im-deltax/EMG-Human-Machine-Interface/EMG8_Wireless.kicad_pcb

## KiCad design EMG8_Wireless.kicad_pcb (2026-10-22)

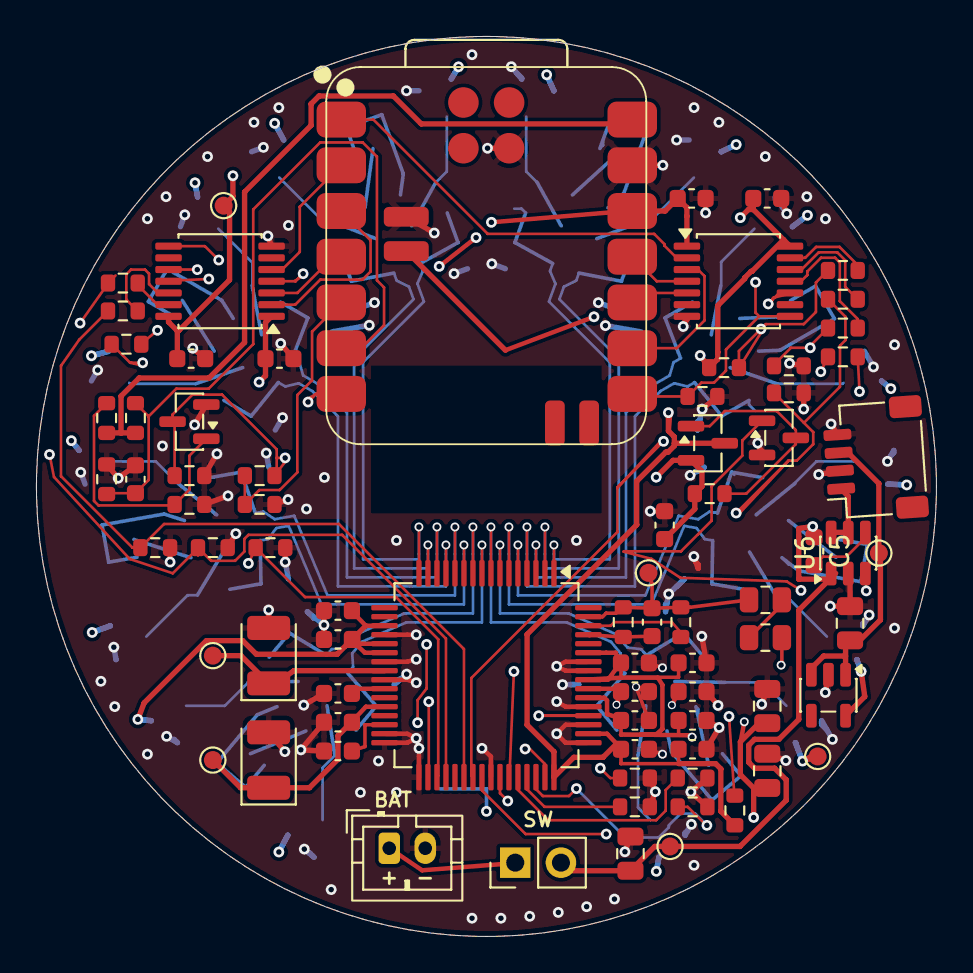
[picture p1: board EMG8_Wireless.kicad_pcb from above]

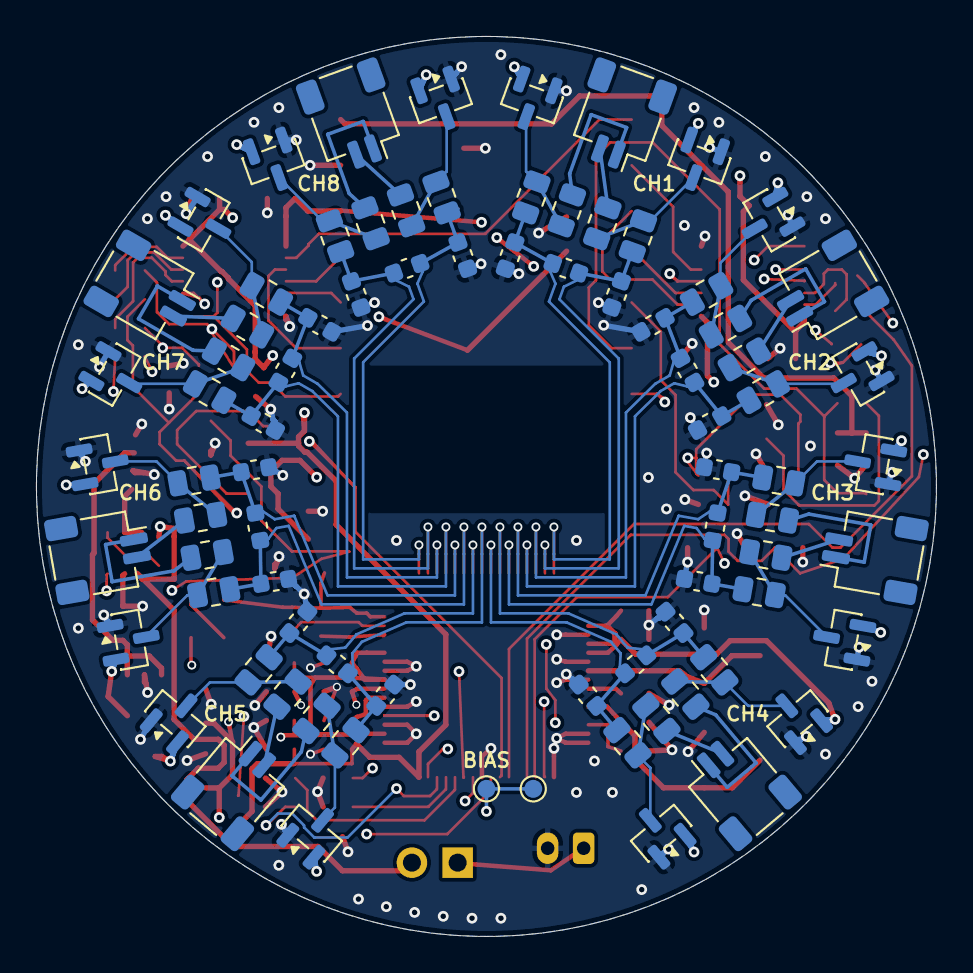
[picture p2: board EMG8_Wireless.kicad_pcb from below]

Board: 4 copper layers, 50.0 x 50.0 mm, 159 parts (82 on the bottom side), 102 nets.

Parts:
C1, C4: 10uF / 10V X7R; C_0805
C2, C3: 2.2uF / 10V X7R; C_0805
C5: 1nF / 25V X7R; C_0603
C10, C12, C14, C16, C22, C23, C25, C42: 1uF / 10V X7R; C_0603
C11, C13, C15, C17, C21, C24, C43, C44, C45, C46: 100nF / 10V X7R; C_0603
C20: 100uF / 6.3V tantalum; C_TANT_B
C26: 22uF / 10V tantalum; C_TANT_B
C40: 470p / C0G 50V; C_0603
C41: 10n / X7R; C_0603
C110, C111, C120, C121, C130, C131, C140, C141, C150, C151, C160, C161, C170, C171, C180, C181: 10p / C0G; C_0603
C112, C122, C132, C142, C152, C162, C172, C182: 220p / C0G; C_0603
D1, D2, D3, D4, D5, D6, D7, D8, D9, D10, D11, D12, D13, D14, D15, D16: BAV99; SOT23
J1: LiPo 1S / protected; JST_PH2
J2: MT3608 / external; JST_SH4
J11: CH1 P / N; JST_SH2
J12: CH2 P / N; JST_SH2
J13: CH3 P / N; JST_SH2
J14: CH4 P / N; JST_SH2
J15: CH5 P / N; JST_SH2
J16: CH6 P / N; JST_SH2
J17: CH7 P / N; JST_SH2
J18: CH8 P / N; JST_SH2
J20: BIAS electrode; TP_1MM
Q2: AO3401A; SOT23
Q4: MMBT3904; SOT23
Q5: BSS138BK; SOT23
R2, R6, R21, R30, R31, R32, R33: 10k; R_0603
R3, R4, R22, R23, R24, R25, R26, R40, R46, R47, R48: 100k; R_0603
R5, R44: 1M; R_0603
R10, R11, R12, R13, R14, R15, R20: 33; R_0603
R41, R42: 1M; R_0805
R43: 0; R_0603
R45: 470k; R_0603
R110, R111, R112, R113, R120, R121, R122, R123, R130, R131, R132, R133, R140, R141, R142, R143, R150, R151, R152, R153, R160, R161, R162, R163, R170, R171, R172, R173, R180, R181, R182, R183: 120k; R_0805
SW1: MAIN / external switch; HDR2
TP1: VBAT_SYS; TP_1MM
TP2: DVDD_3V3; TP_1MM
TP3: BOOST_5V4; TP_1MM
TP5: AVDD_5V; TP_1MM
TP6: VCAP1; TP_1MM
TP7: VREFP; TP_1MM
TP8: BIASOUT; TP_1MM
TP9: BIAS_ELECTRODE; TP_1MM
U1: ADS1299IPAG; TQFP64
U2: XIAO nRF52840; XIAO_nRF52840_SMD
U3: TPS7A2050PDBVR; SOT23_5
U4, U5: TXU0304PWR; TSSOP14
U6: TPS22917DBVR; SOT23_6

Connections:
3V3_MCU: C42.1, C43.1, C45.1, Q2.2 (S), R6.1, U2.12 (3V3_OUT), U4.1 (VCCA), U5.1 (VCCA)
ADS_CLKSEL: R21.2, U1.52 (CLKSEL)
ADS_CS: R10.1, R22.2, U1.39 (~CS)
ADS_DIN: R15.1, R47.1, U1.34 (DIN)
ADS_DOUT: R20.1, U1.43 (DOUT)
ADS_DRDY: U1.47 (~DRDY), U5.10 (B4)
ADS_GPIO1: R30.1, U1.42 (GPIO1)
ADS_GPIO2: R31.1, U1.44 (GPIO2)
ADS_GPIO3: R32.1, U1.45 (GPIO3)
ADS_GPIO4: R33.1, U1.46 (GPIO4)
ADS_PWDN: R13.1, R25.1, U1.35 (~PWDN)
ADS_RESET: R11.1, R24.1, U1.36 (~RESET)
ADS_SCLK: R14.1, R48.1, U1.40 (SCLK)
ADS_START: R12.1, R23.1, U1.38 (START)
AFE_BASE: Q4.3 (C), Q5.1 (G), R2.2, R3.1, U6.3 (ON)
AFE_CT: C5.2, U6.4 (CT)
AFE_EN: R2.1, R26.1, U2.5 (D4_/_AFE_EN)
AFE_IO_EN: R46.1, U2.8 (D7_/_AFE_IO_EN), U4.8 (OE), U5.8 (OE)
AVDD_5V: C3.1, C4.1, C10.1, C11.1, C12.1, C13.1, C14.1, C15.1, D1.2 (K), D2.2 (K), D3.2 (K), D4.2 (K), D5.2 (K), D6.2 (K), D7.2 (K), D8.2 (K), D9.2 (K), D10.2 (K), D11.2 (K), D12.2 (K), D13.2 (K), D14.2 (K), D15.2 (K), D16.2 (K), TP5.1, U1.19 (AVDD), U1.21 (AVDD), U1.22 (AVDD), U1.54 (AVDD1), U1.56 (AVDD), U1.59 (AVDD), U3.5 (OUT)
BAT_RAW: J1.1, SW1.1
BIASIN: R43.2, U1.62 (BIASIN)
BIASINV: C40.2, R40.2, U1.61 (BIASINV)
BIASOUT: C40.1, R40.1, R41.1, R43.1, TP8.1, U1.63 (BIASOUT)
BIAS_ELECTRODE: J20.1, R42.2, TP9.1
BIAS_LIMIT_MID: R41.2, R42.1
BOOST_5V4: C2.1, J2.3 (VOUT+), TP3.1, U3.1 (IN), U3.3 (EN)
BUF_CS: R10.2, U4.13 (B1Y)
BUF_DIN: R15.2, U4.11 (B3Y)
BUF_PWDN: R13.2, U5.11 (B3Y)
BUF_RESET: R11.2, U5.13 (B1Y)
BUF_SCLK: R14.2, U4.12 (B2Y)
BUF_START: R12.2, U5.12 (B2Y)
CH1_N: C111.1, C112.2, R113.2, U1.15 (IN1N)
CH1_P: C110.1, C112.1, R111.2, U1.16 (IN1P)
CH2_N: C121.1, C122.2, R123.2, U1.13 (IN2N)
CH2_P: C120.1, C122.1, R121.2, U1.14 (IN2P)
CH3_N: C131.1, C132.2, R133.2, U1.11 (IN3N)
CH3_P: C130.1, C132.1, R131.2, U1.12 (IN3P)
CH4_N: C141.1, C142.2, R143.2, U1.9 (IN4N)
CH4_P: C140.1, C142.1, R141.2, U1.10 (IN4P)
CH5_N: C151.1, C152.2, R153.2, U1.7 (IN5N)
CH5_P: C150.1, C152.1, R151.2, U1.8 (IN5P)
CH6_N: C161.1, C162.2, R163.2, U1.5 (IN6N)
CH6_P: C160.1, C162.1, R161.2, U1.6 (IN6P)
CH7_N: C171.1, C172.2, R173.2, U1.3 (IN7N)
CH7_P: C170.1, C172.1, R171.2, U1.4 (IN7P)
CH8_N: C181.1, C182.2, R183.2, U1.1 (IN8N)
CH8_P: C180.1, C182.1, R181.2, U1.2 (IN8P)
DVDD_3V3: C16.1, C17.1, C44.1, C46.1, Q2.3 (D), R21.1, R22.1, TP2.1, U1.48 (DVDD), U1.50 (DVDD), U4.14 (VCCB), U5.14 (VCCB)
DVDD_GATE: Q2.1 (G), Q5.3 (D), R6.2
GND: C1.2, C2.2, C3.2, C4.2, C10.2, C11.2, C12.2, C13.2, C14.2, C15.2, C16.2, C17.2, C20.2, C21.2, C22.2, C23.2, C24.2, C25.2, C26.2, C41.2, C42.2, C43.2, C44.2, C45.2, C46.2, C110.2, C111.2, C120.2, C121.2, C130.2, C131.2, C140.2, C141.2, C150.2, C151.2, C160.2, C161.2, C170.2, C171.2, C180.2, C181.2, D1.1 (A), D2.1 (A), D3.1 (A), D4.1 (A), D5.1 (A), D6.1 (A), D7.1 (A), D8.1 (A), D9.1 (A), D10.1 (A), D11.1 (A), D12.1 (A), D13.1 (A), D14.1 (A), D15.1 (A), D16.1 (A), J1.2, J2.2 (VIN-), J2.4 (VOUT-), Q4.2 (E), Q5.2 (S), R3.2, R5.2, R23.2, R24.2, R25.2, R26.2, R30.2, R31.2, R32.2, R33.2, R45.2, R46.2, R47.2, R48.2, U1.20 (AVSS), U1.23 (AVSS), U1.25 (VREFN), U1.31 (RESV1), U1.32 (AVSS), U1.33 (DGND), U1.41 (DAISY_IN), U1.49 (DGND), U1.51 (DGND), U1.53 (AVSS1), U1.57 (AVSS), U1.58 (AVSS), U2.13 (GND), U2.18 (GND_(rear)), U2.20 (BAT-_(rear)), U3.2 (GND), U4.7 (GND), U5.7 (GND), U6.2 (GND)
MCU_CS: U2.1 (D0_/_CS), U4.2 (A1)
MCU_DIN: U2.11 (D10_/_MOSI), U4.4 (A3)
MCU_DRDY: U2.2 (D1_/_DRDY), U5.5 (A4Y)
MCU_MISO: U2.10 (D9_/_MISO), U4.5 (A4Y)
MCU_PWDN: U2.7 (D6_/_PWDN), U5.4 (A3)
MCU_RESET: U2.3 (D2_/_RESET), U5.2 (A1)
MCU_SCLK: U2.9 (D8_/_SCK), U4.3 (A2)
MCU_START: U2.4 (D3_/_START), U5.3 (A2)
unnamed: D1.3 (common), R110.2, R111.1
unnamed: D2.3 (common), R112.2, R113.1
unnamed: D3.3 (common), R120.2, R121.1
unnamed: D4.3 (common), R122.2, R123.1
unnamed: D5.3 (common), R130.2, R131.1
unnamed: D6.3 (common), R132.2, R133.1
unnamed: D7.3 (common), R140.2, R141.1
unnamed: D8.3 (common), R142.2, R143.1
unnamed: D9.3 (common), R150.2, R151.1
unnamed: D10.3 (common), R152.2, R153.1
unnamed: D11.3 (common), R160.2, R161.1
unnamed: D12.3 (common), R162.2, R163.1
unnamed: D13.3 (common), R170.2, R171.1
unnamed: D14.3 (common), R172.2, R173.1
unnamed: D15.3 (common), R180.2, R181.1
unnamed: D16.3 (common), R182.2, R183.1
unnamed: J11.1, R110.1
unnamed: J11.2, R112.1
unnamed: J12.1, R120.1
unnamed: J12.2, R122.1
unnamed: J13.1, R130.1
unnamed: J13.2, R132.1
unnamed: J14.1, R140.1
unnamed: J14.2, R142.1
unnamed: J15.1, R150.1
unnamed: J15.2, R152.1
unnamed: J16.1, R160.1
unnamed: J16.2, R162.1
unnamed: J17.1, R170.1
unnamed: J17.2, R172.1
unnamed: J18.1, R180.1
unnamed: J18.2, R182.1
SPI_MISO: R20.2, U4.10 (B4)
USB_INHIBIT_BASE: Q4.1 (B), R4.2, R5.1
USB_VBUS: R4.1, R44.1, U2.14 (VBUS_/_USB_5V)
VBAT_AFE: J2.1 (VIN+), U6.5 (QOD), U6.6 (VOUT)
VBAT_SYS: C1.1, C5.1, SW1.2, TP1.1, U2.19 (VBAT_(rear_pad)), U6.1 (VIN)
VBUS_SENSE: C41.1, R44.2, R45.1, U2.6 (D5_/_VBUS_ADC)
VCAP1: C20.1, C21.1, TP6.1, U1.28 (VCAP1)
VCAP2: C22.1, U1.30 (VCAP2)
VCAP3: C23.1, C24.1, U1.55 (VCAP3)
VCAP4: C25.1, U1.26 (VCAP4)
VREFP: C26.1, TP7.1, U1.24 (VREFP)
